go4retro/UltiMEM/media/IMG_0143.jpg

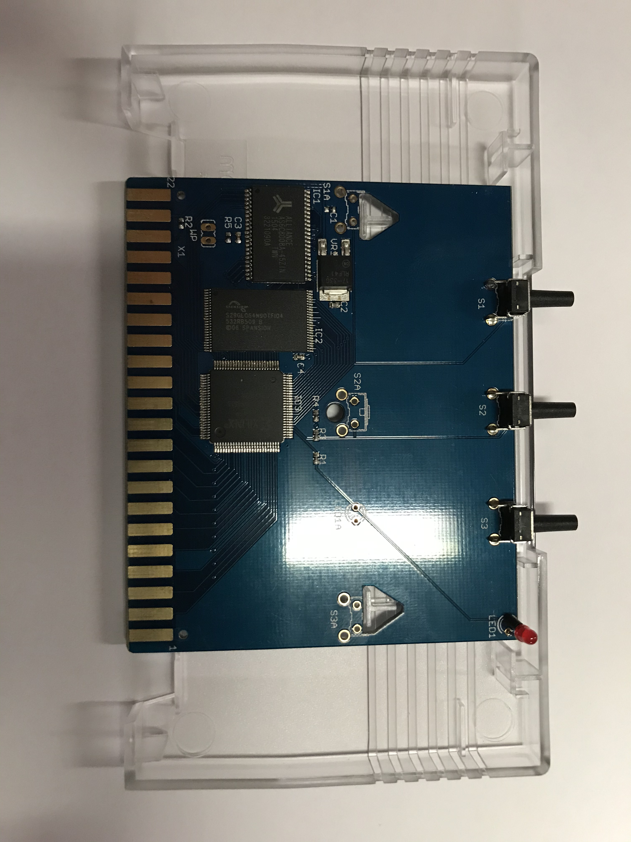
media/IMG_0143.jpg
