go4retro/UltiMEM/media/IMG_0045.JPG

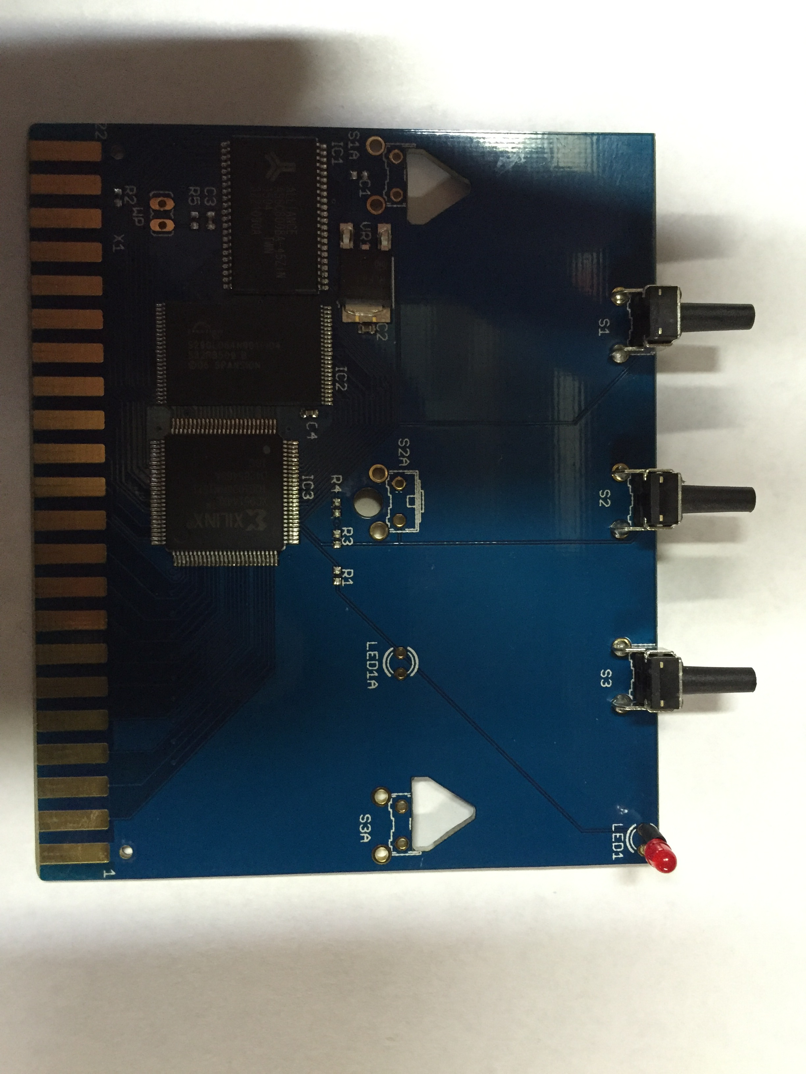
media/IMG_0045.JPG
