go4retro/UltiMEM/media/IMG_0032.JPG

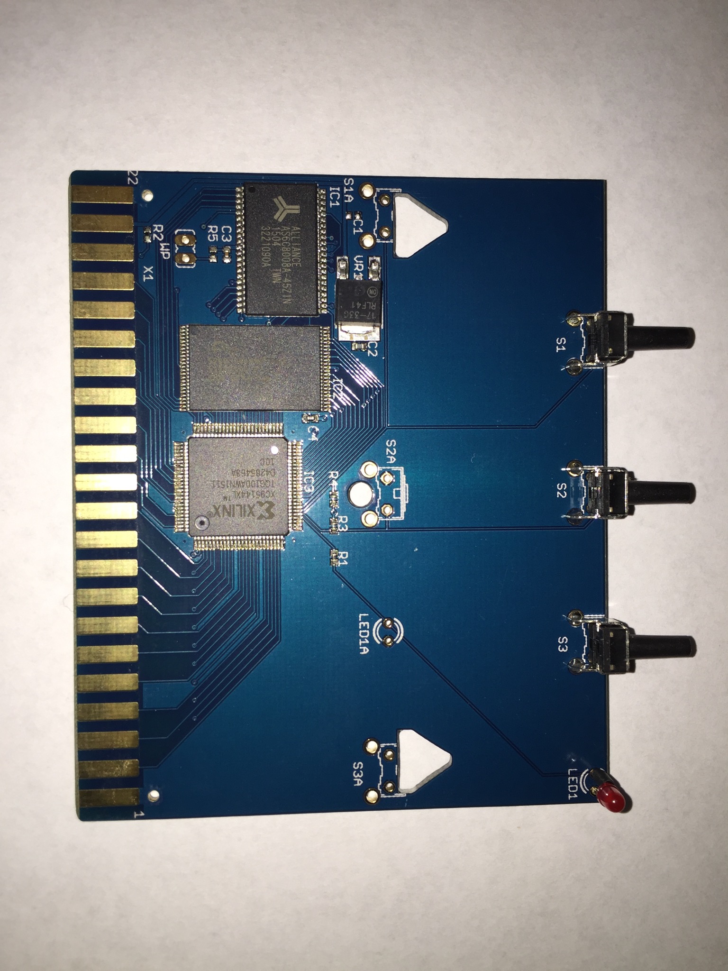
media/IMG_0032.JPG
