go4retro/UltiMEM/media/IMG_0143.JPEG

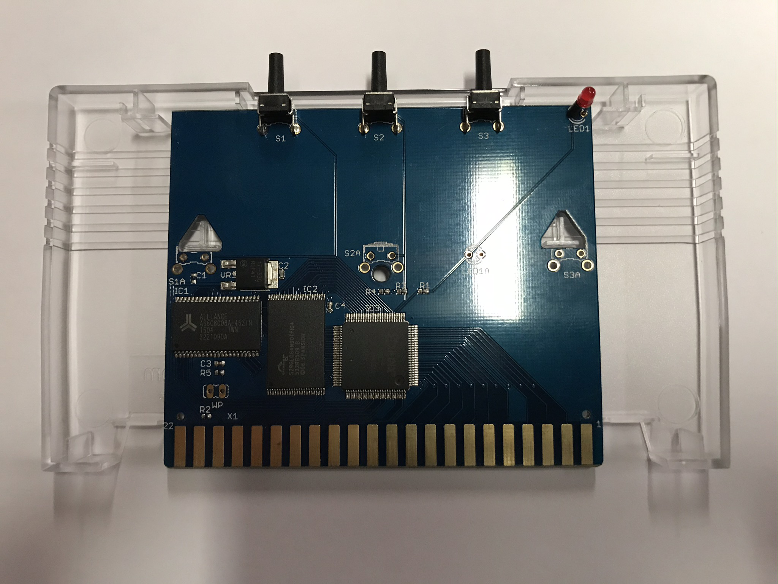
media/IMG_0143.JPEG
