go4retro/UltiMEM/media/IMG_0146.JPEG

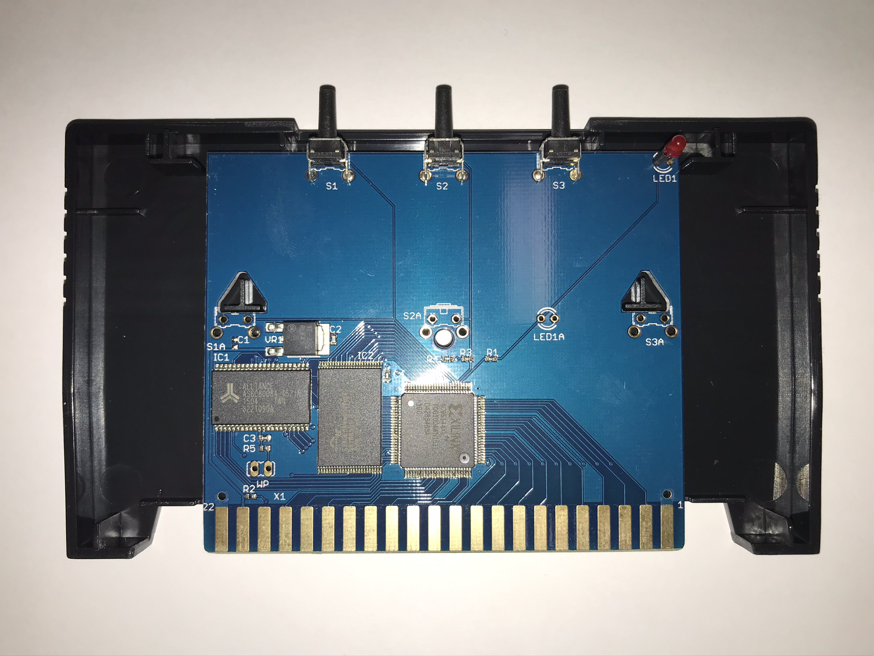
media/IMG_0146.JPEG
