go4retro/UltiMEM/media/IMG_0146.jpg

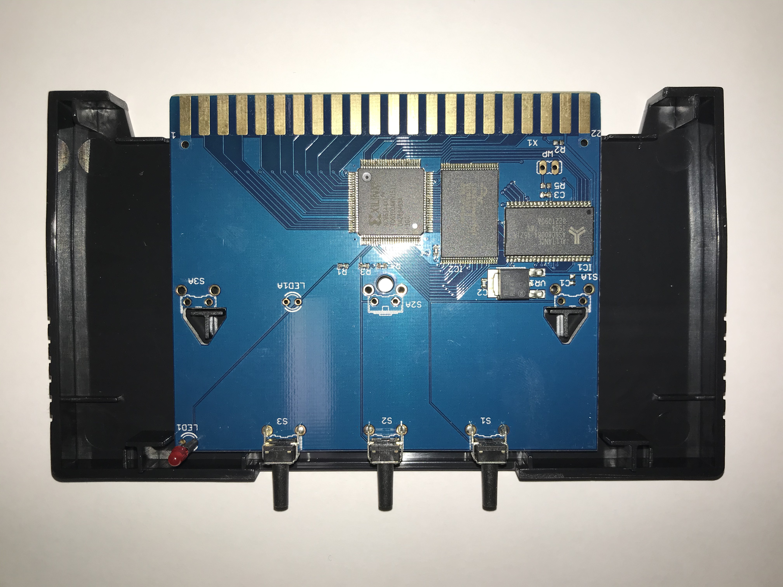
media/IMG_0146.jpg
