go4retro/UltiMEM/media/IMG_1708.JPG

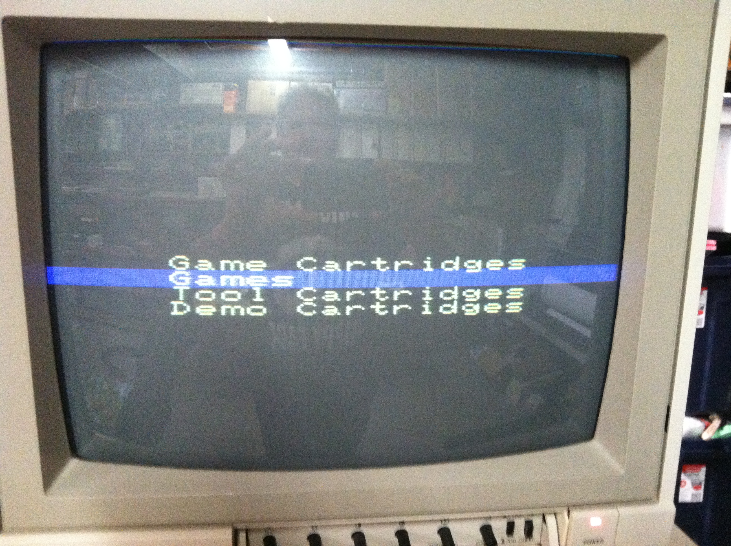
media/IMG_1708.JPG
