go4retro/UltiMEM/media/IMG_1709.JPG

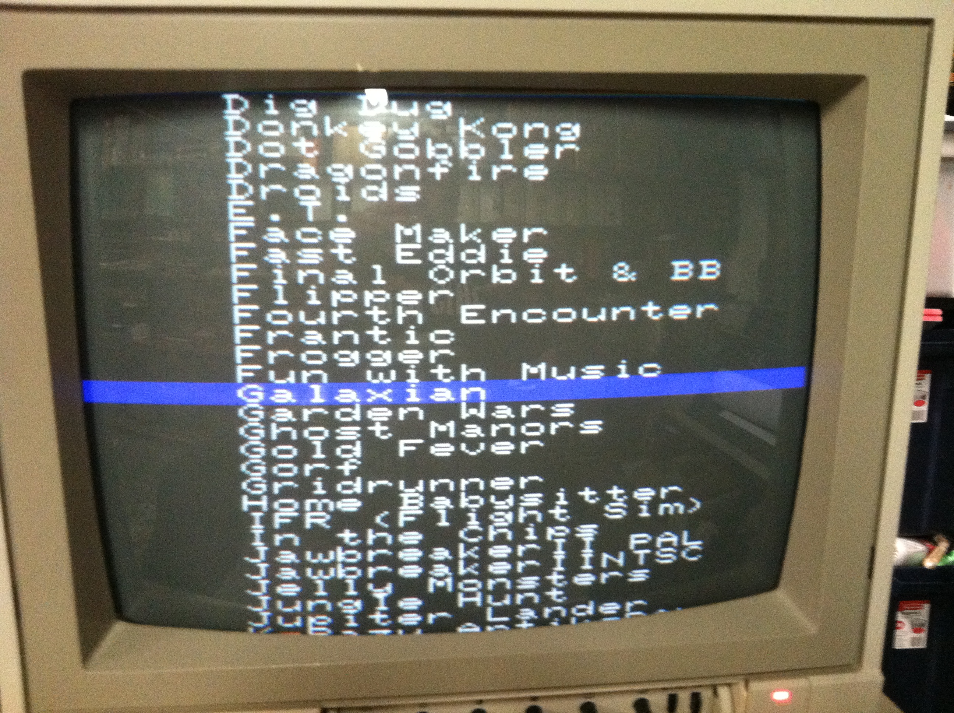
media/IMG_1709.JPG
