go4retro/UltiMEM/media/IMG_1710.JPG

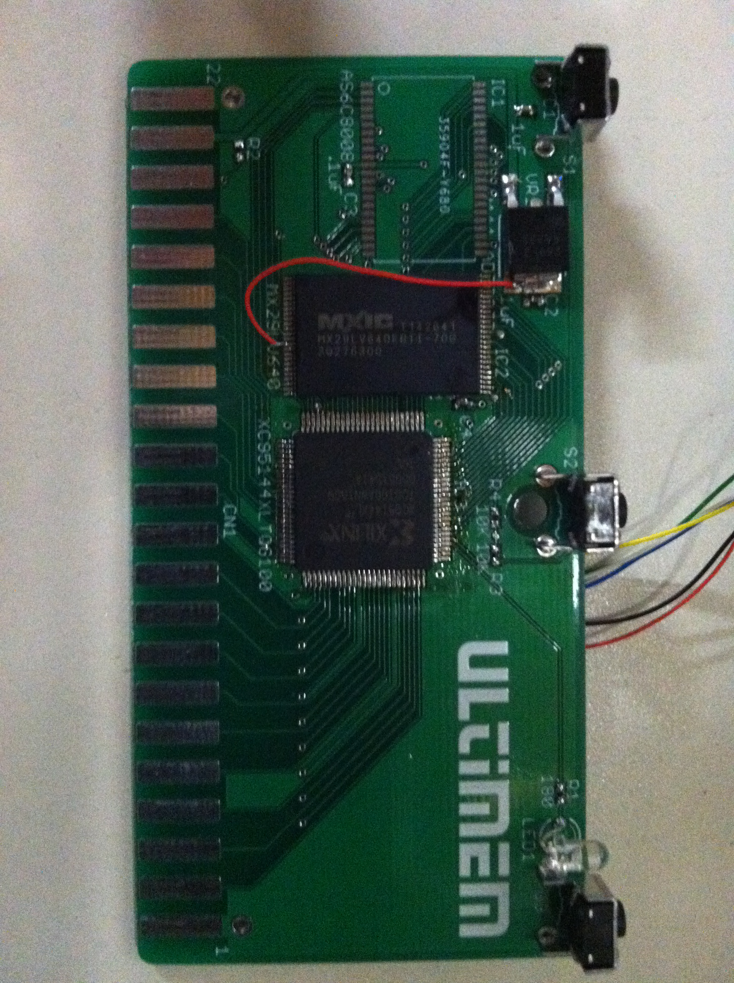
media/IMG_1710.JPG
