go4retro/UltiMEM/media/IMG_1711.JPG

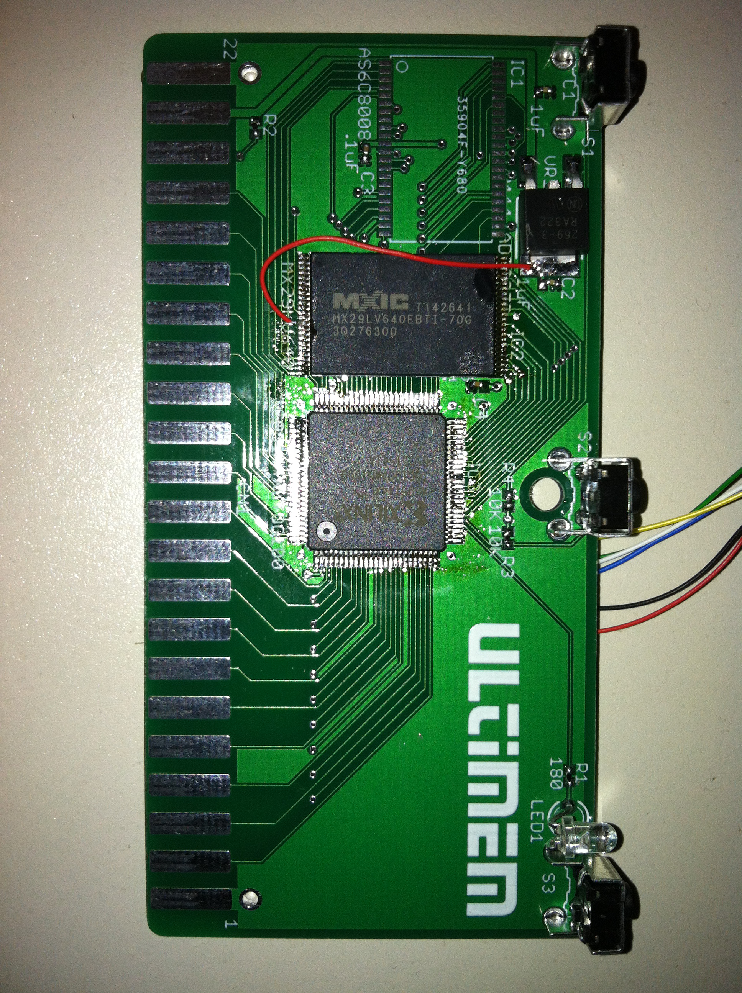
media/IMG_1711.JPG
