go4retro/UltiMEM/media/UltiMem PCB.png

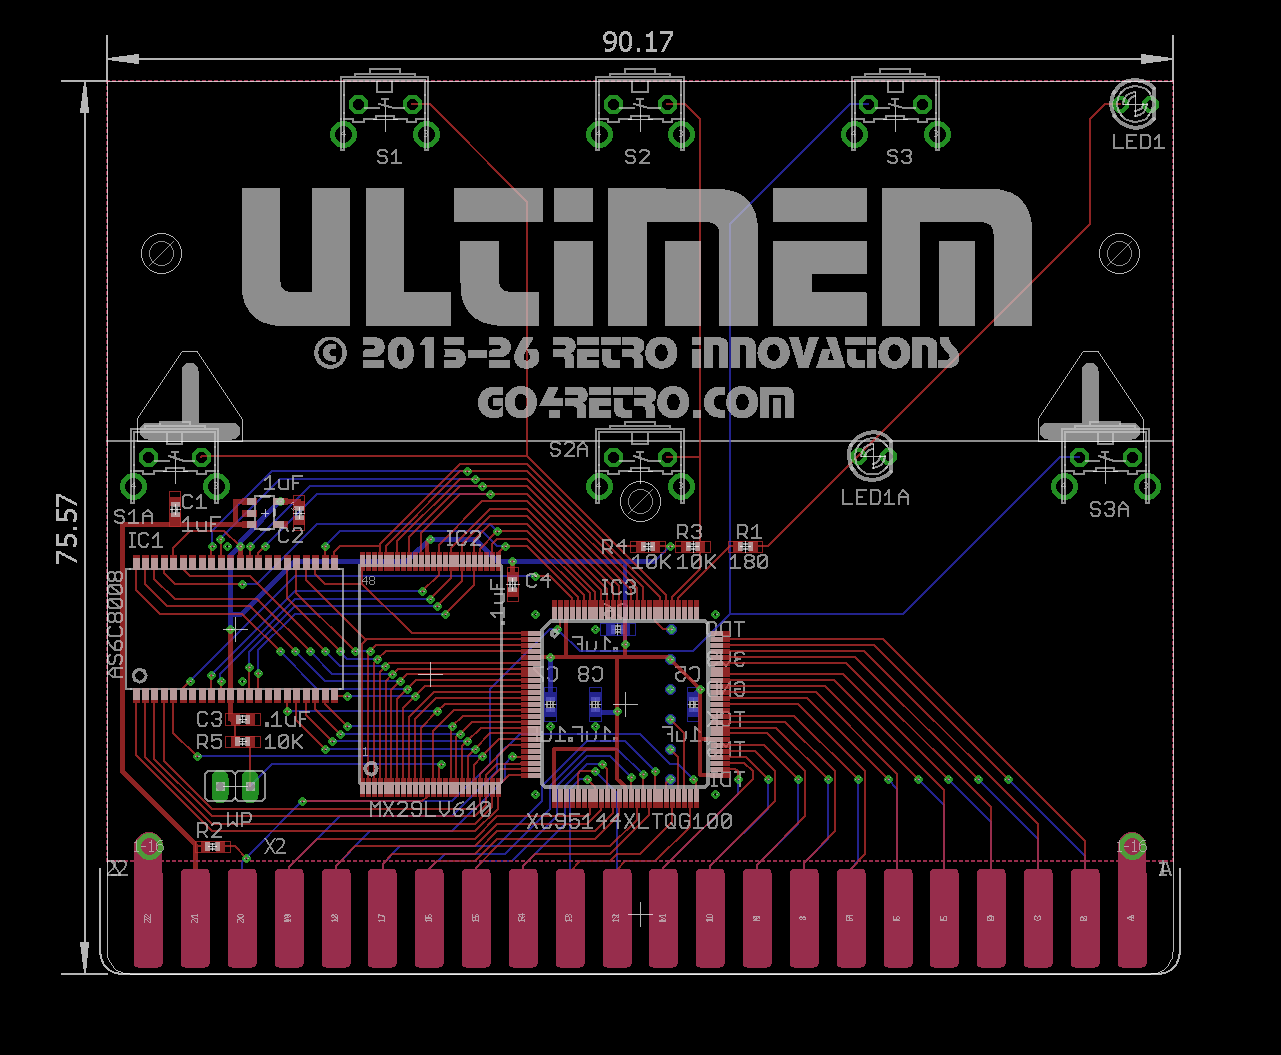
media/UltiMem PCB.png
