go4retro/UltiMEM/media/UltiMem Schematic (1 of 5).png

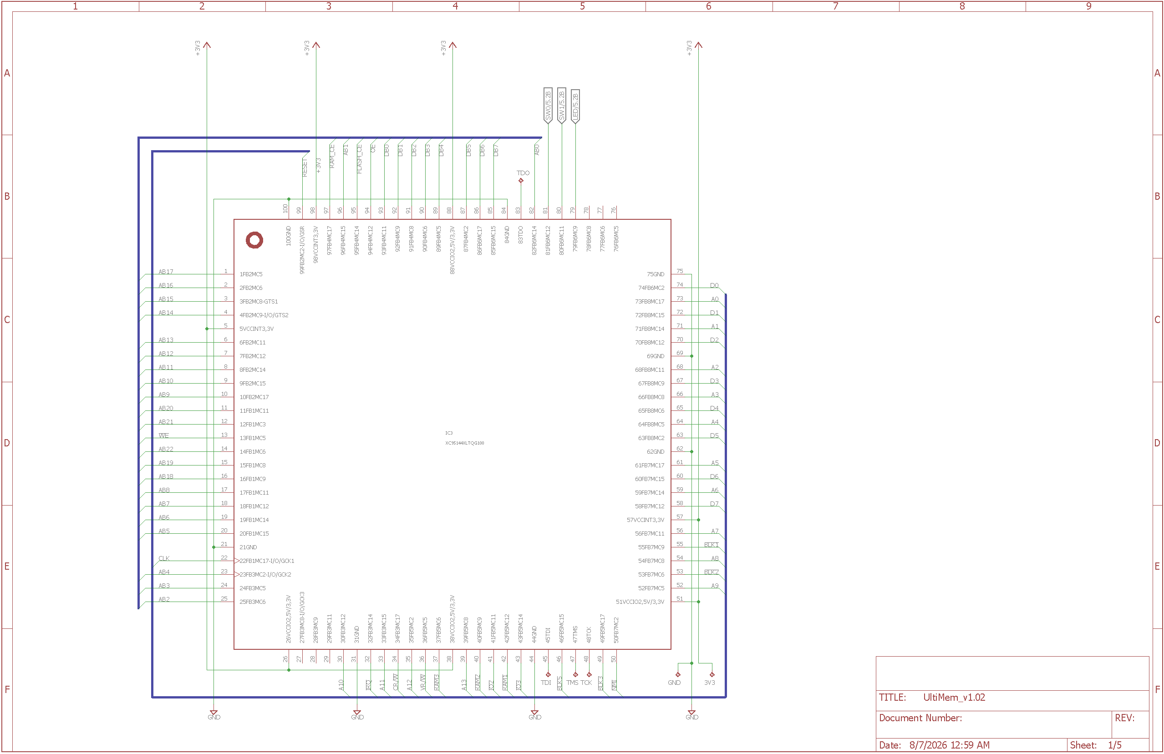
media/UltiMem Schematic (1 of 5).png
