go4retro/UltiMEM/media/UltiMem Schematic (2 of 5).png

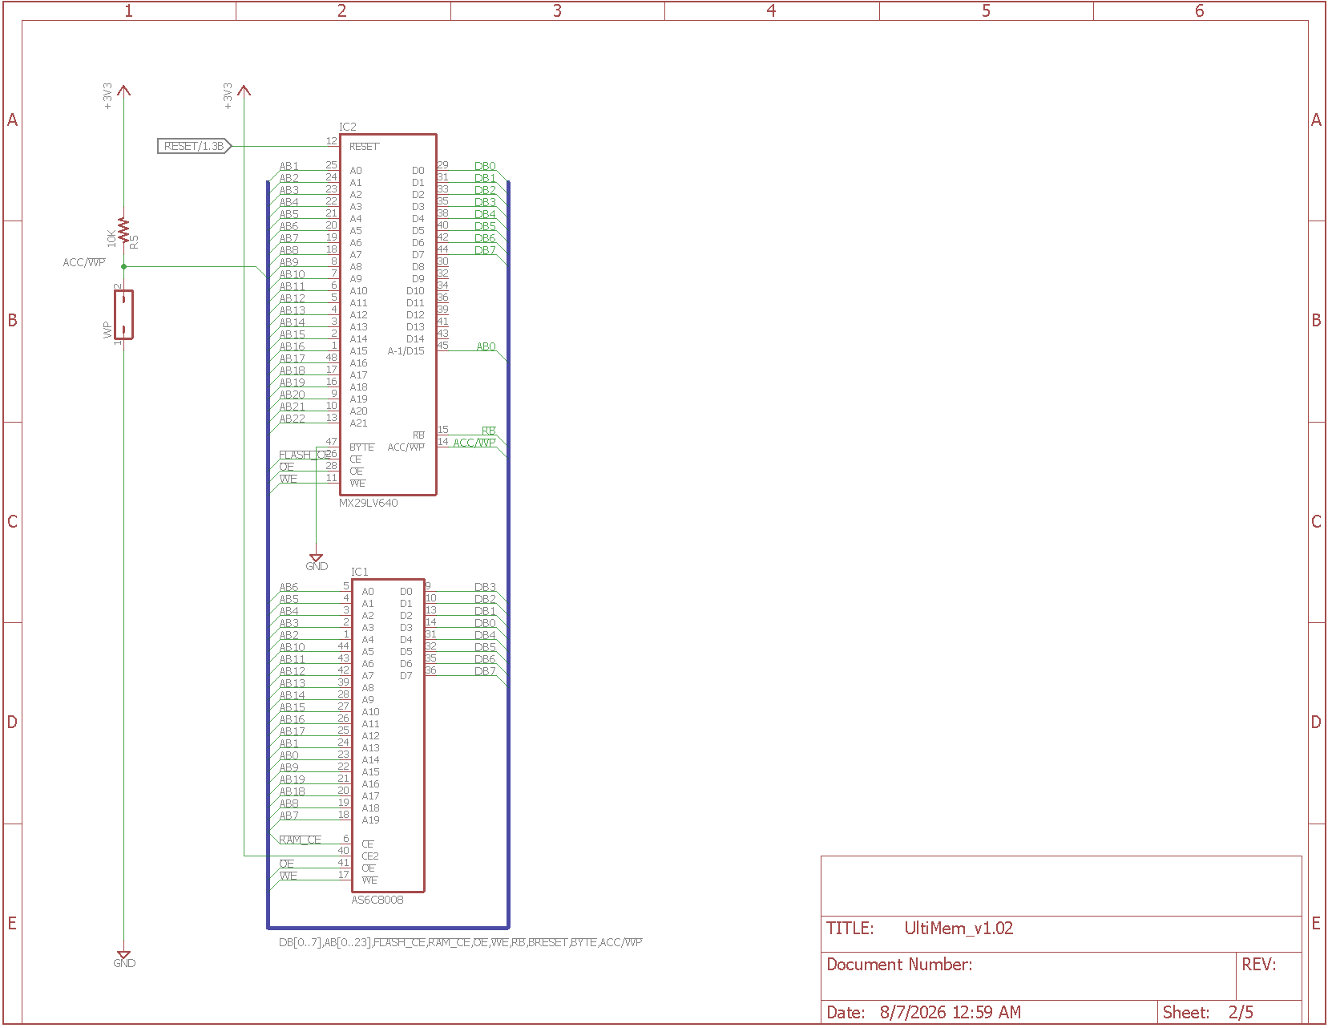
media/UltiMem Schematic (2 of 5).png
