go4retro/UltiMEM/media/UltiMem Schematic (3 of 5).png

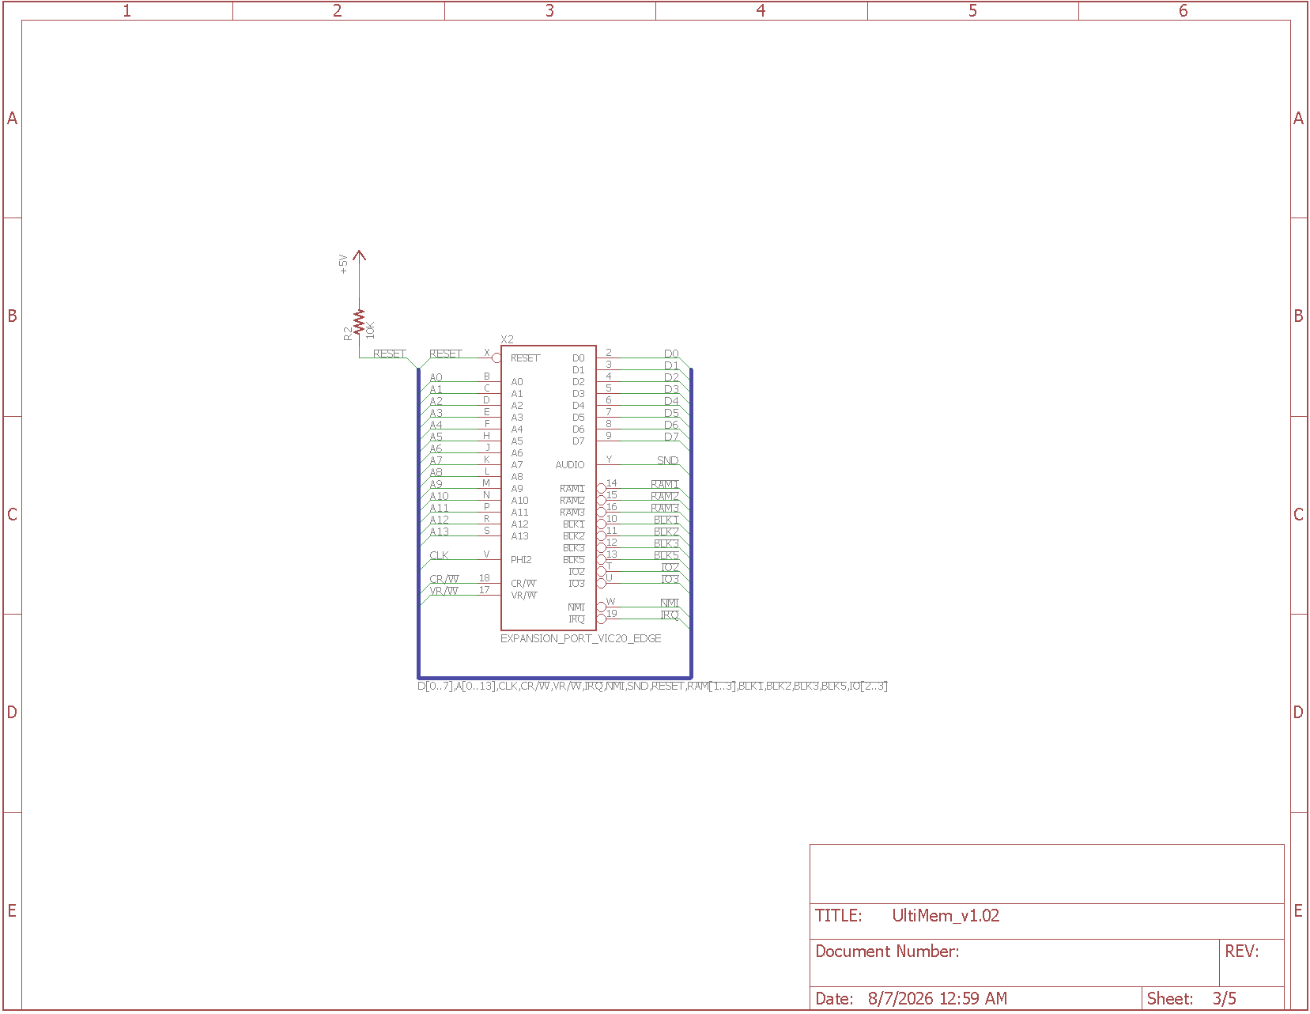
media/UltiMem Schematic (3 of 5).png
