go4retro/UltiMEM/media/UltiMem Schematic (4 of 5).png

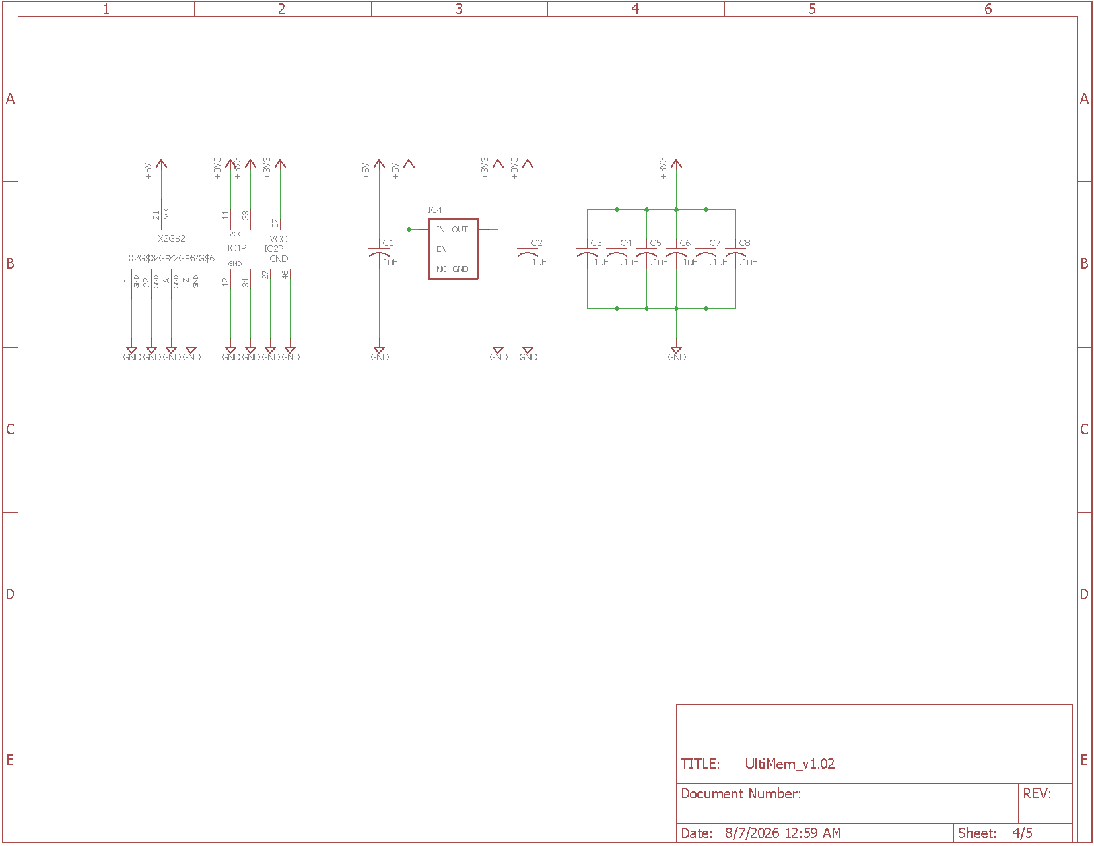
media/UltiMem Schematic (4 of 5).png
