go4retro/UltiMEM/media/UltiMem Schematic (5 of 5).png

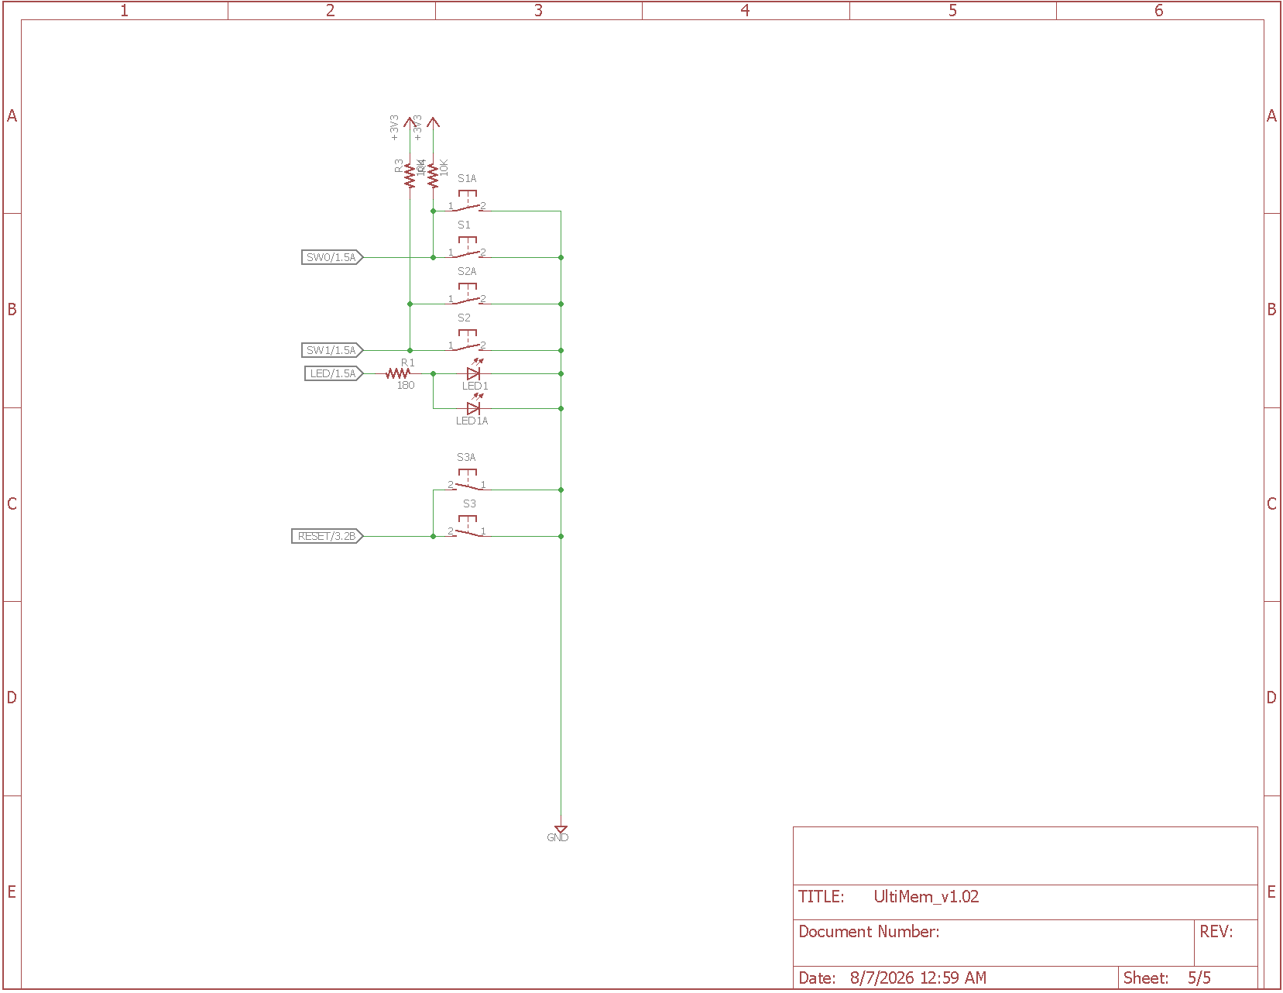
media/UltiMem Schematic (5 of 5).png
