go4retro/UltiMEM/pcb/UltiMem PCB.png

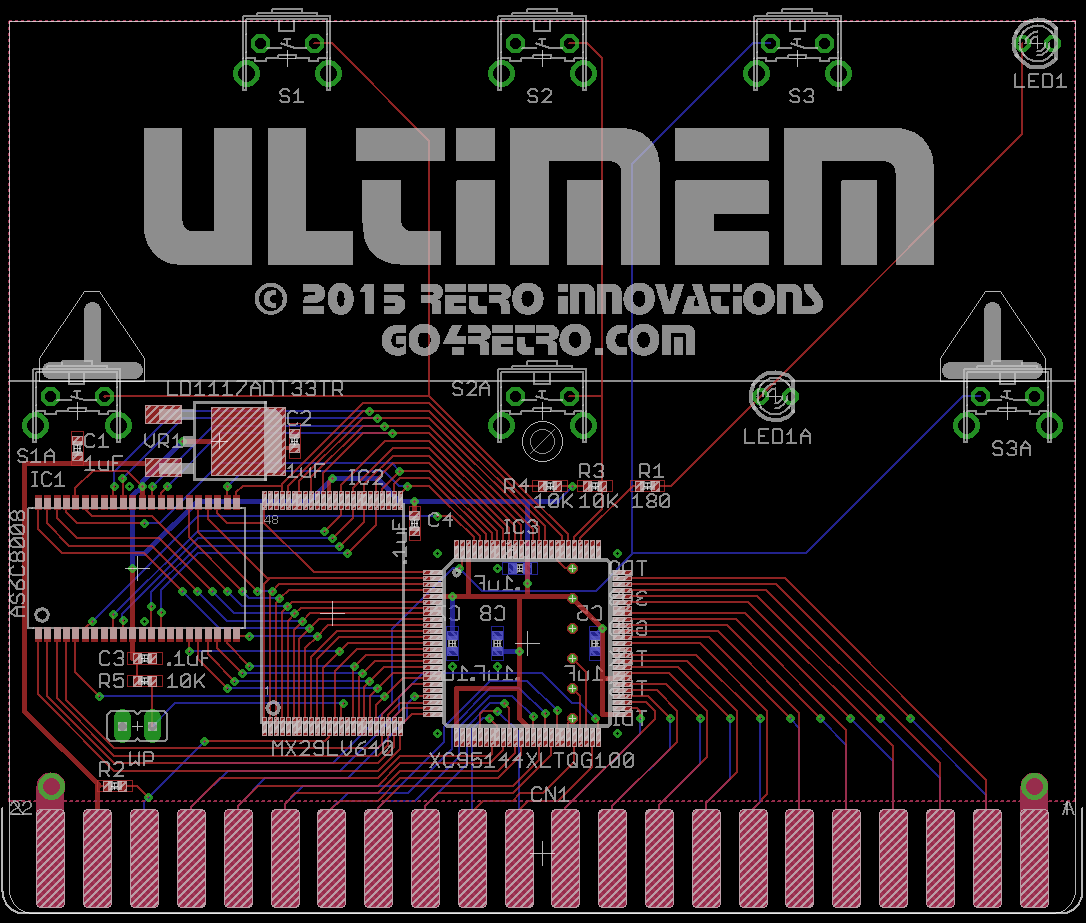
pcb/UltiMem PCB.png
