go4retro/UltiMEM/pcb/UltiMem Schematic (1 of 3).png

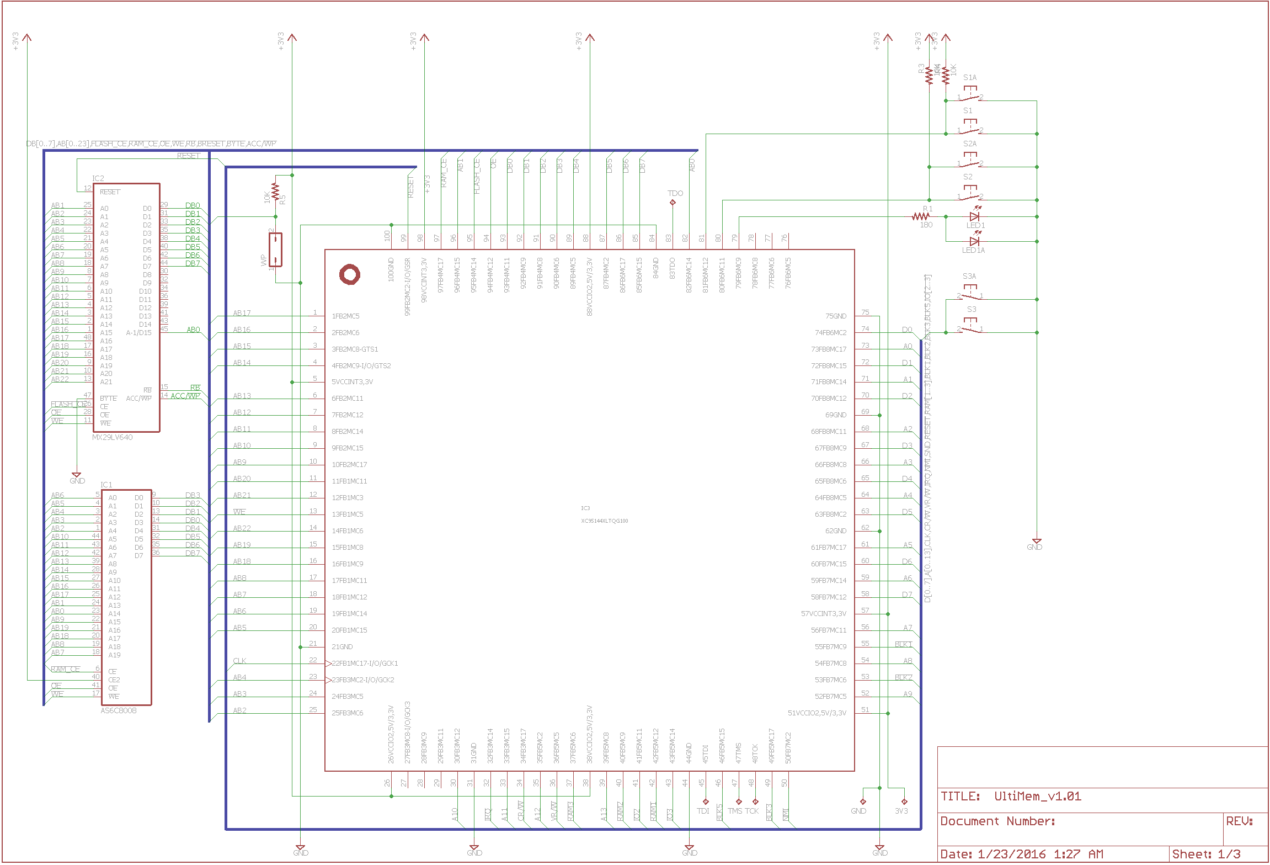
pcb/UltiMem Schematic (1 of 3).png
