go4retro/UltiMEM/pcb/UltiMem Schematic (2 of 3).png

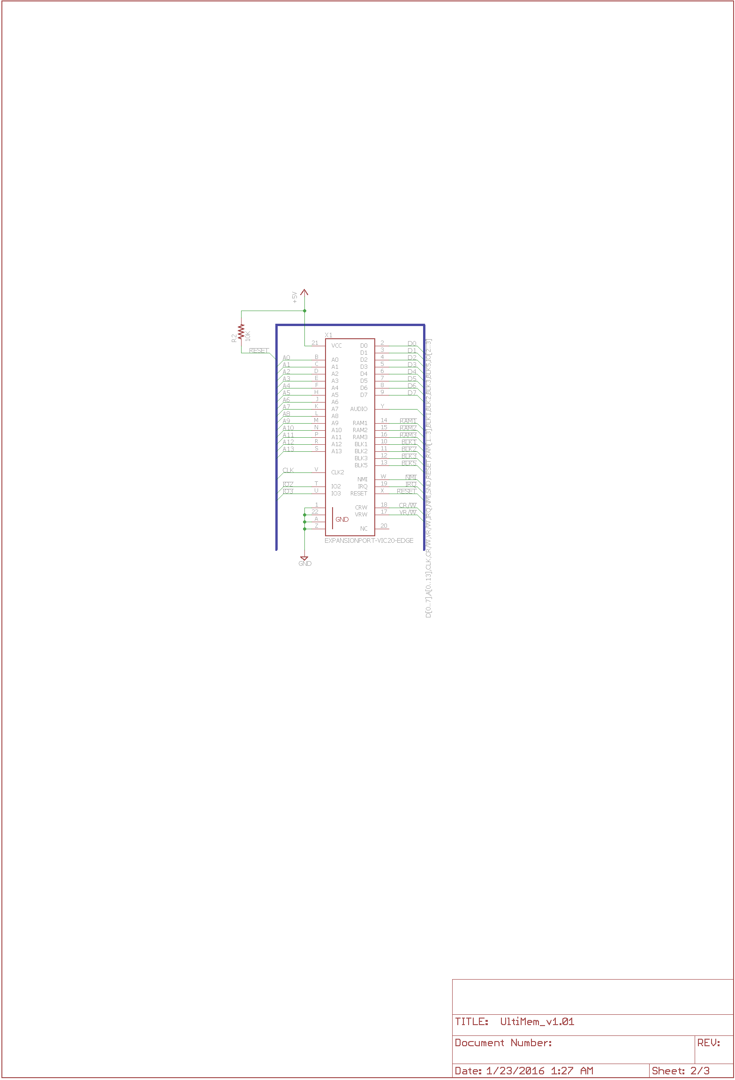
pcb/UltiMem Schematic (2 of 3).png
