go4retro/UltiMEM/pcb/UltiMem Schematic (3 of 3).png

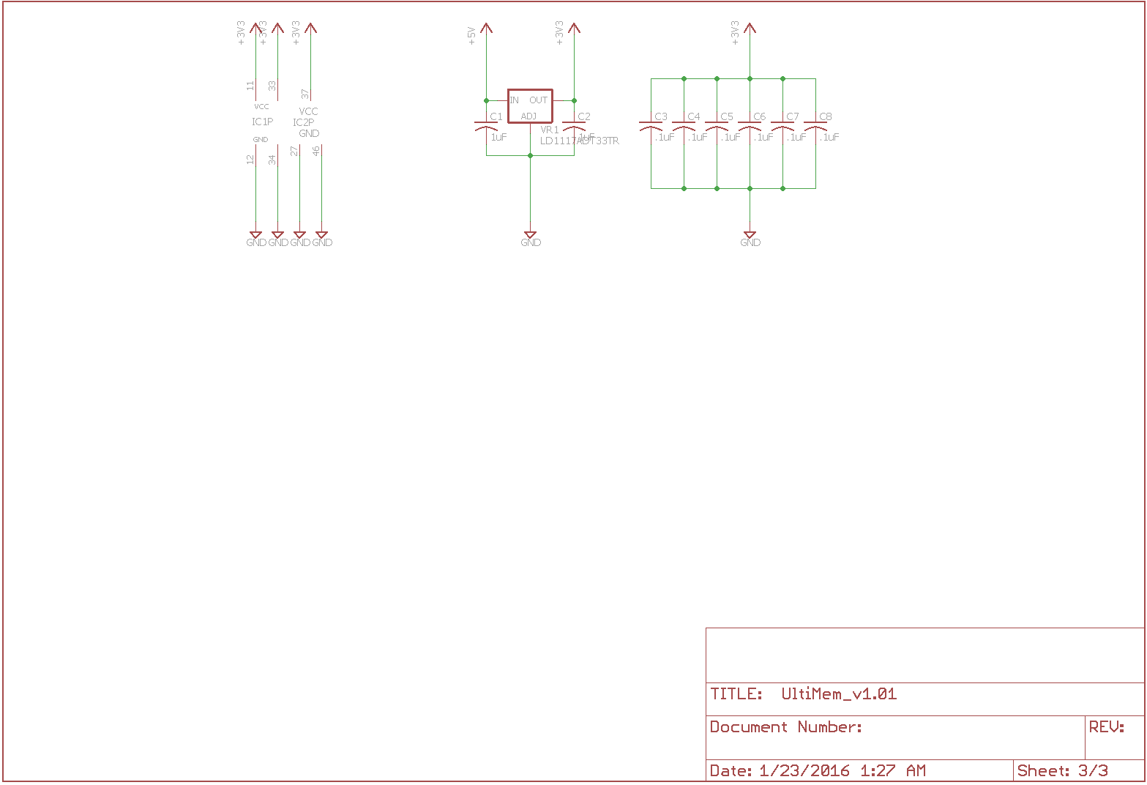
pcb/UltiMem Schematic (3 of 3).png
