go4retro/UltiMEM/pcb/UltiMem_v1.02_BOM.xlsx

Legend | Quantity | Description | Part Number | Unit Cost | Total
IC1 | 1 | 1MB RAM | AS6C8008-55ZIN | $4.60 | $4.60
IC2 | 1 | 8MB FLASH | S29GL064S70TFI040 | $1.12 | $1.12
IC3 | 1 | CPLD | XC95144XL-TQ100 | $2.40 | $2.40
VR1 | 1 | Voltage regulator | TLV77733PDBVR | $0.31 | $0.31
S1,S2,S3 | 3 | RA tactile switch | TS11-674-85-BK-160-RA-D | $0.10 | $0.31
LED1 | 1 | LED | XCMDK11D | $0.14 | $0.14
R1 | 1 | 1K | 0402 package | $0.0047 | $0.0047
R2,R3,R4,R5 | 4 | 10K | 0402 package | $0.01 | $0.03
C1,C2 | 2 | 1uF | 0402 pkg | $0.19 | $0.39
C3-C8 | 6 | .1uF | 0402 pkg | $0.01 | $0.06
