go4retro/UltiMEM/pcb/UltiMem_1.01_BOM.xlsm

Legend | Quantity | Description | Part Number
IC1 | 1 | 1MB RAM | AS6C8008A-45ZIN (http://www.digikey.com/product-detail/en/AS6C8008A-45ZIN/1450-1189-5-ND/4499097)
IC2 | 1 | 8MB FLASH | S29GL064N90TFI040
IC3 | 1 | CPLD | XC95144XL-TQ100
VR1 | 1 | Voltage regulator | LD1117ADT33TR
S1,S2,S3 | 3 | RA tactile switch
LED1 | 1 | LED | WP710A10LSRD
R1 | 1 | 1K | 0402 package
R2,R3,R4,R5 | 4 | 10K | 0402 package
C1,C2 | 2 | 10uF | 0402 pkg
C3-C8 | 6 | .1uF | 0402 pkg
