go4retro/UltiMEM/pcb/UltiMem_v1.02.brd

## EAGLE design pcb/UltiMem_v1.02.brd (2026-08-27)

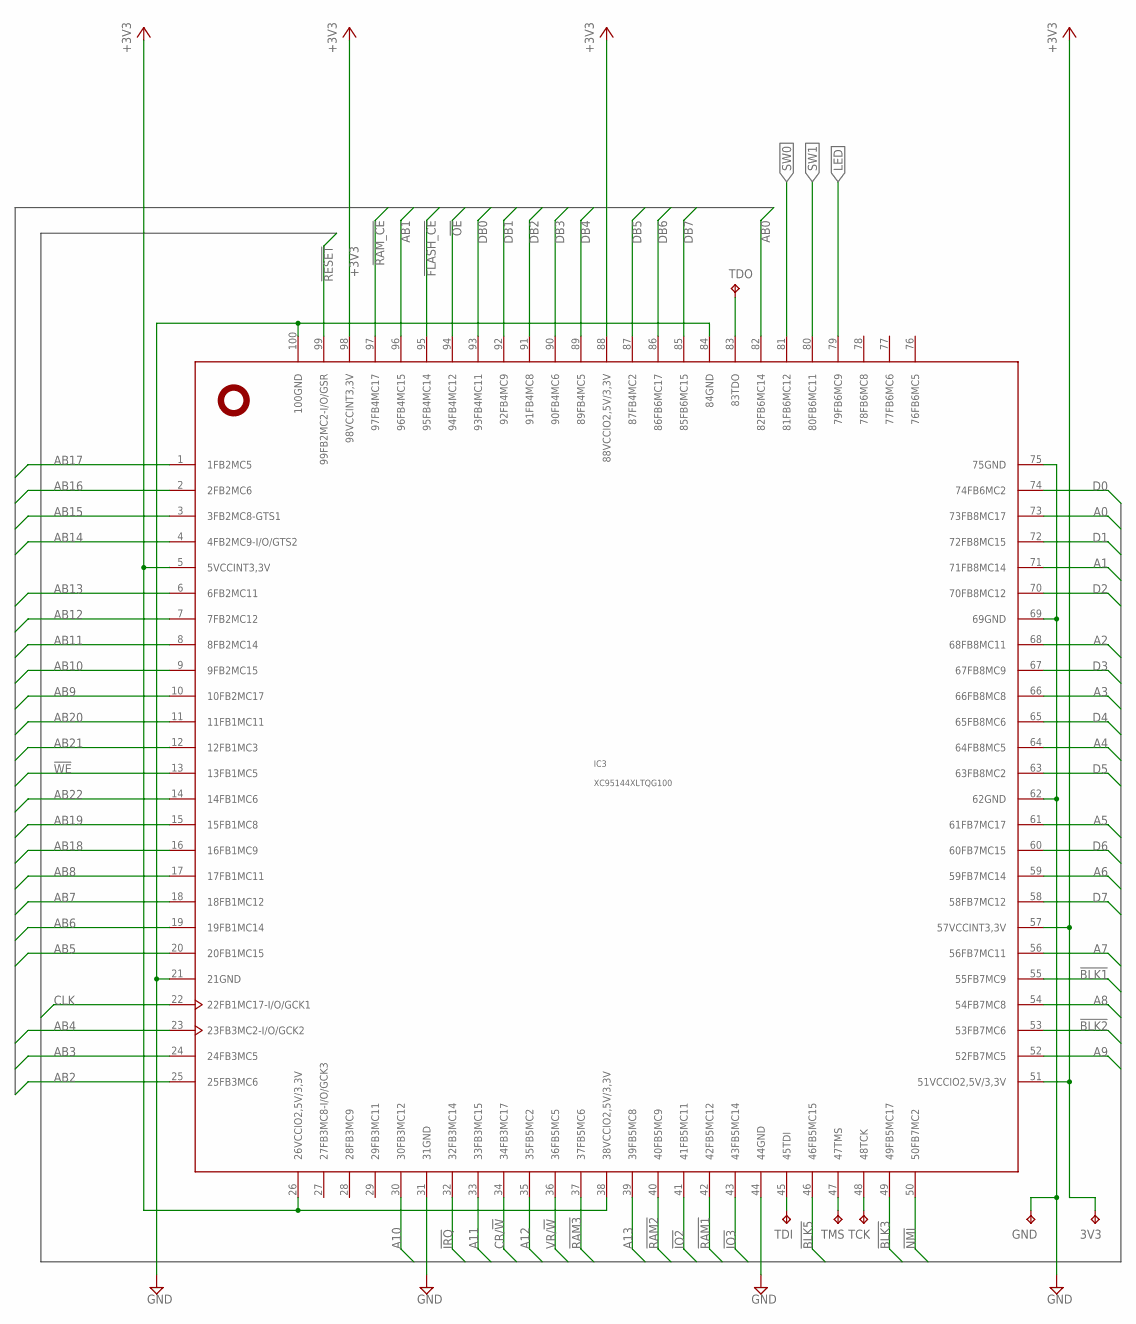
[picture p23: schematic UltiMem_v1.02.sch, sheet 1, LOGIC]

Parts:
3V3: TPTP08R; TP08R
GND: TPTP08R; TP08R
IC3: XC95144XLTQG100; TQFP100
TCK: TPTP08R; TP08R
TDI: TPTP08R; TP08R
TDO: TPTP08R; TP08R
TMS: TPTP08R; TP08R

Connections:
!BLK1: IC3.55 (55FB7MC9); also elsewhere on the board
!BLK2: IC3.53 (53FB7MC6); also elsewhere on the board
!BLK3: IC3.49 (49FB5MC17); also elsewhere on the board
!BLK5: IC3.46 (46FB5MC15); also elsewhere on the board
!FLASH_CE: IC3.95 (95FB4MC14); also elsewhere on the board
!IO2: IC3.41 (41FB5MC11); also elsewhere on the board
!IO3: IC3.43 (43FB5MC14); also elsewhere on the board
!IRQ: IC3.32 (32FB3MC14); also elsewhere on the board
!NMI: IC3.50 (50FB7MC2); also elsewhere on the board
!OE: IC3.94 (94FB4MC12); also elsewhere on the board
!RAM1: IC3.42 (42FB5MC12); also elsewhere on the board
!RAM2: IC3.40 (40FB5MC9); also elsewhere on the board
!RAM3: IC3.37 (37FB5MC6); also elsewhere on the board
!RAM_CE: IC3.97 (97FB4MC17); also elsewhere on the board
!RESET: IC3.99 (99FB2MC2-I/O/GSR); also elsewhere on the board
!WE: IC3.13 (13FB1MC5); also elsewhere on the board
+3V3: 3V3.TP, IC3.5 (5VCCINT3,3V), IC3.26 (26VCCIO2,5V/3,3V), IC3.38 (38VCCIO2,5V/3,3V), IC3.51 (51VCCIO2,5V/3,3V), IC3.57 (57VCCINT3,3V), IC3.88 (88VCCIO2,5V/3,3V), IC3.98 (98VCCINT3,3V); also elsewhere on the board
A0: IC3.73 (73FB8MC17); also elsewhere on the board
A1: IC3.71 (71FB8MC14); also elsewhere on the board
A2: IC3.68 (68FB8MC11); also elsewhere on the board
A3: IC3.66 (66FB8MC8); also elsewhere on the board
A4: IC3.64 (64FB8MC5); also elsewhere on the board
A5: IC3.61 (61FB7MC17); also elsewhere on the board
A6: IC3.59 (59FB7MC14); also elsewhere on the board
A7: IC3.56 (56FB7MC11); also elsewhere on the board
A8: IC3.54 (54FB7MC8); also elsewhere on the board
A9: IC3.52 (52FB7MC5); also elsewhere on the board
A10: IC3.30 (30FB3MC12); also elsewhere on the board
A11: IC3.33 (33FB3MC15); also elsewhere on the board
A12: IC3.35 (35FB5MC2); also elsewhere on the board
A13: IC3.39 (39FB5MC8); also elsewhere on the board
AB0: IC3.82 (82FB6MC14); also elsewhere on the board
AB1: IC3.96 (96FB4MC15); also elsewhere on the board
AB2: IC3.25 (25FB3MC6); also elsewhere on the board
AB3: IC3.24 (24FB3MC5); also elsewhere on the board
AB4: IC3.23 (23FB3MC2-I/O/GCK2); also elsewhere on the board
AB5: IC3.20 (20FB1MC15); also elsewhere on the board
AB6: IC3.19 (19FB1MC14); also elsewhere on the board
AB7: IC3.18 (18FB1MC12); also elsewhere on the board
AB8: IC3.17 (17FB1MC11); also elsewhere on the board
AB9: IC3.10 (10FB2MC17); also elsewhere on the board
AB10: IC3.9 (9FB2MC15); also elsewhere on the board
AB11: IC3.8 (8FB2MC14); also elsewhere on the board
AB12: IC3.7 (7FB2MC12); also elsewhere on the board
AB13: IC3.6 (6FB2MC11); also elsewhere on the board
AB14: IC3.4 (4FB2MC9-I/O/GTS2); also elsewhere on the board
AB15: IC3.3 (3FB2MC8-GTS1); also elsewhere on the board
AB16: IC3.2 (2FB2MC6); also elsewhere on the board
AB17: IC3.1 (1FB2MC5); also elsewhere on the board
AB18: IC3.16 (16FB1MC9); also elsewhere on the board
AB19: IC3.15 (15FB1MC8); also elsewhere on the board
AB20: IC3.11 (11FB1MC11); also elsewhere on the board
AB21: IC3.12 (12FB1MC3); also elsewhere on the board
AB22: IC3.14 (14FB1MC6); also elsewhere on the board
CLK: IC3.22 (22FB1MC17-I/O/GCK1); also elsewhere on the board
CR/!W: IC3.34 (34FB3MC17); also elsewhere on the board
D0: IC3.74 (74FB6MC2); also elsewhere on the board
D1: IC3.72 (72FB8MC15); also elsewhere on the board
D2: IC3.70 (70FB8MC12); also elsewhere on the board
D3: IC3.67 (67FB8MC9); also elsewhere on the board
D4: IC3.65 (65FB8MC6); also elsewhere on the board
D5: IC3.63 (63FB8MC2); also elsewhere on the board
D6: IC3.60 (60FB7MC15); also elsewhere on the board
D7: IC3.58 (58FB7MC12); also elsewhere on the board
DB0: IC3.93 (93FB4MC11); also elsewhere on the board
DB1: IC3.92 (92FB4MC9); also elsewhere on the board
DB2: IC3.91 (91FB4MC8); also elsewhere on the board
DB3: IC3.90 (90FB4MC6); also elsewhere on the board
DB4: IC3.89 (89FB4MC5); also elsewhere on the board
DB5: IC3.87 (87FB4MC2); also elsewhere on the board
DB6: IC3.86 (86FB6MC17); also elsewhere on the board
DB7: IC3.85 (85FB6MC15); also elsewhere on the board
GND: GND.TP, IC3.21 (21GND), IC3.31 (31GND), IC3.44 (44GND), IC3.62 (62GND), IC3.69 (69GND), IC3.75 (75GND), IC3.84 (84GND), IC3.100 (100GND); also elsewhere on the board
LED: IC3.79 (79FB6MC9); also elsewhere on the board
unnamed: IC3.45 (45TDI), TDI.TP
unnamed: IC3.47 (47TMS), TMS.TP
unnamed: IC3.48 (48TCK), TCK.TP
unnamed: IC3.83 (83TDO), TDO.TP
SW0: IC3.81 (81FB6MC12); also elsewhere on the board
SW1: IC3.80 (80FB6MC11); also elsewhere on the board
VR/!W: IC3.36 (36FB5MC5); also elsewhere on the board

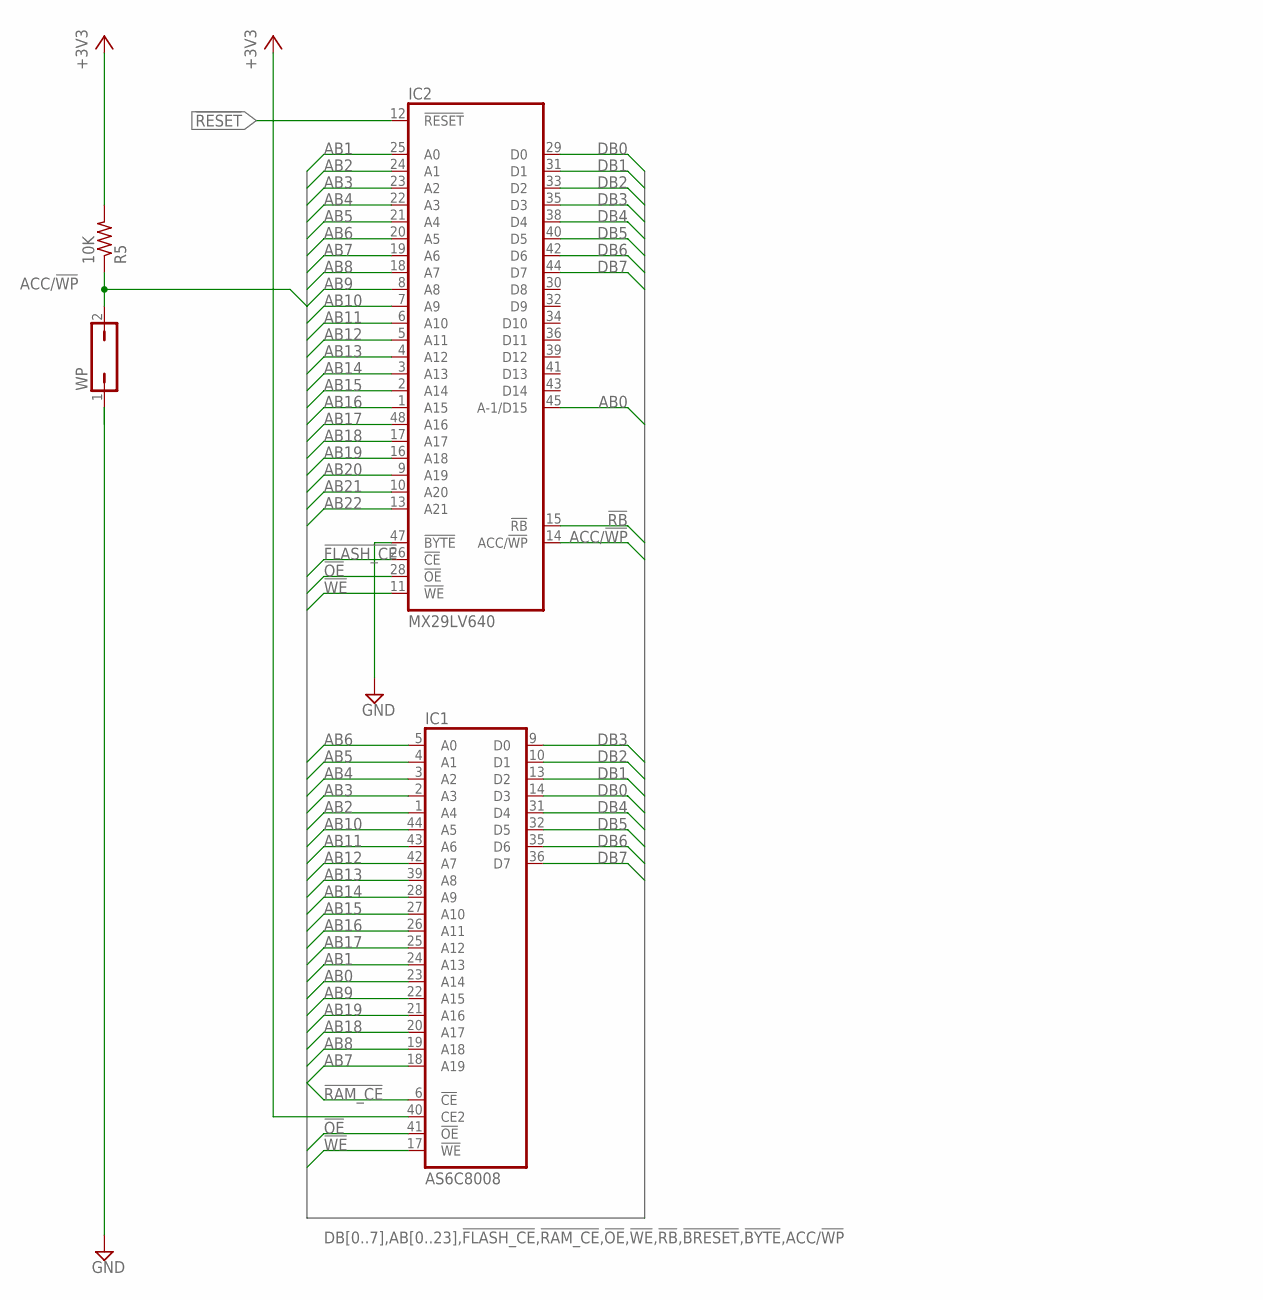
[picture p24: schematic UltiMem_v1.02.sch, sheet 2, MEMORY]

Parts:
IC1: AS6C8008; TSOP44
IC2: MX29LV640; TSOP48
R5: 10K; R0402
WP: JP1Q; JP1

Connections:
!FLASH_CE: IC2.26 (!CE); also elsewhere on the board
!OE: IC1.41 (!OE), IC2.28 (!OE); also elsewhere on the board
!RAM_CE: IC1.6 (!CE); also elsewhere on the board
!RB: IC2.15 (!RB)
!RESET: IC2.12 (!RESET); also elsewhere on the board
!WE: IC1.17 (!WE), IC2.11 (!WE); also elsewhere on the board
+3V3: IC1.40 (CE2), R5.2; also elsewhere on the board
AB0: IC1.23 (A14), IC2.45 (A-1/D15); also elsewhere on the board
AB1: IC1.24 (A13), IC2.25 (A0); also elsewhere on the board
AB2: IC1.1 (A4), IC2.24 (A1); also elsewhere on the board
AB3: IC1.2 (A3), IC2.23 (A2); also elsewhere on the board
AB4: IC1.3 (A2), IC2.22 (A3); also elsewhere on the board
AB5: IC1.4 (A1), IC2.21 (A4); also elsewhere on the board
AB6: IC1.5 (A0), IC2.20 (A5); also elsewhere on the board
AB7: IC1.18 (A19), IC2.19 (A6); also elsewhere on the board
AB8: IC1.19 (A18), IC2.18 (A7); also elsewhere on the board
AB9: IC1.22 (A15), IC2.8 (A8); also elsewhere on the board
AB10: IC1.44 (A5), IC2.7 (A9); also elsewhere on the board
AB11: IC1.43 (A6), IC2.6 (A10); also elsewhere on the board
AB12: IC1.42 (A7), IC2.5 (A11); also elsewhere on the board
AB13: IC1.39 (A8), IC2.4 (A12); also elsewhere on the board
AB14: IC1.28 (A9), IC2.3 (A13); also elsewhere on the board
AB15: IC1.27 (A10), IC2.2 (A14); also elsewhere on the board
AB16: IC1.26 (A11), IC2.1 (A15); also elsewhere on the board
AB17: IC1.25 (A12), IC2.48 (A16); also elsewhere on the board
AB18: IC1.20 (A17), IC2.17 (A17); also elsewhere on the board
AB19: IC1.21 (A16), IC2.16 (A18); also elsewhere on the board
AB20: IC2.9 (A19); also elsewhere on the board
AB21: IC2.10 (A20); also elsewhere on the board
AB22: IC2.13 (A21); also elsewhere on the board
ACC/!WP: IC2.14 (ACC/!WP), R5.1, WP.2
DB0: IC1.14 (D3), IC2.29 (D0); also elsewhere on the board
DB1: IC1.13 (D2), IC2.31 (D1); also elsewhere on the board
DB2: IC1.10 (D1), IC2.33 (D2); also elsewhere on the board
DB3: IC1.9 (D0), IC2.35 (D3); also elsewhere on the board
DB4: IC1.31 (D4), IC2.38 (D4); also elsewhere on the board
DB5: IC1.32 (D5), IC2.40 (D5); also elsewhere on the board
DB6: IC1.35 (D6), IC2.42 (D6); also elsewhere on the board
DB7: IC1.36 (D7), IC2.44 (D7); also elsewhere on the board
GND: IC2.47 (!BYTE), WP.1; also elsewhere on the board

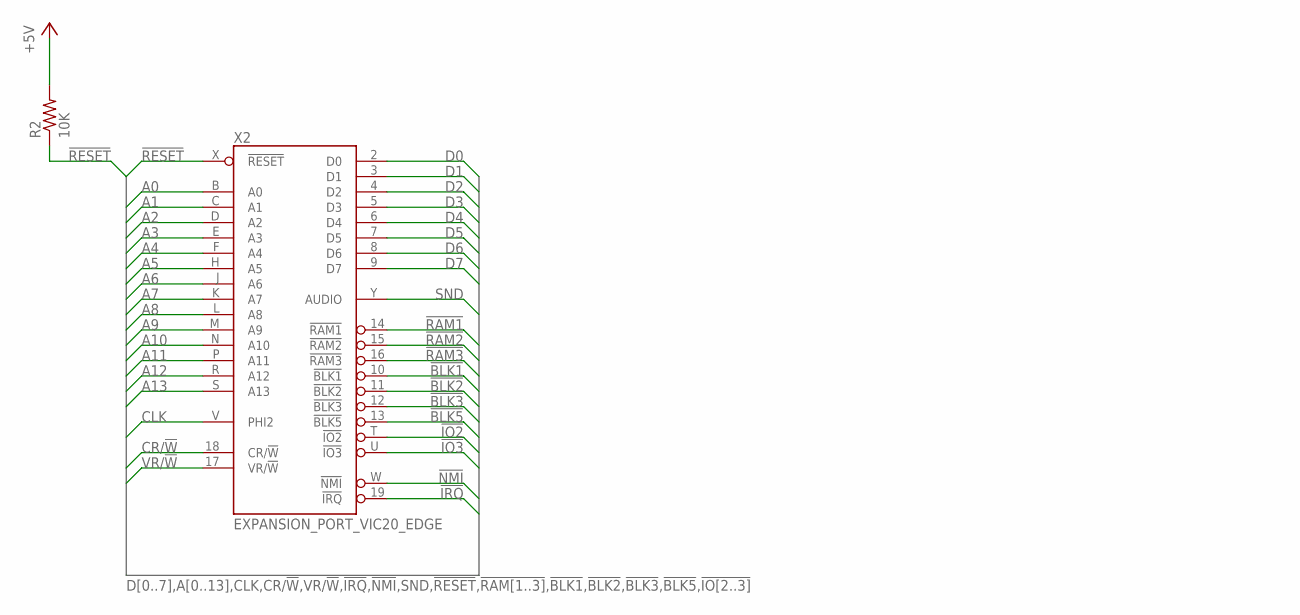
[picture p25: schematic UltiMem_v1.02.sch, sheet 3, INTERFACE]

Parts:
R2: 10K; R0402
X2: EXPANSION_PORT_VIC20_EDGE; MA156-22-2

Connections:
!BLK1: X2.10 (!BLK1); also elsewhere on the board
!BLK2: X2.11 (!BLK2); also elsewhere on the board
!BLK3: X2.12 (!BLK3); also elsewhere on the board
!BLK5: X2.13 (!BLK5); also elsewhere on the board
!IO2: X2.T (!IO2); also elsewhere on the board
!IO3: X2.U (!IO3); also elsewhere on the board
!IRQ: X2.19 (!IRQ); also elsewhere on the board
!NMI: X2.W (!NMI); also elsewhere on the board
!RAM1: X2.14 (!RAM1); also elsewhere on the board
!RAM2: X2.15 (!RAM2); also elsewhere on the board
!RAM3: X2.16 (!RAM3); also elsewhere on the board
!RESET: R2.1, X2.X (!RESET); also elsewhere on the board
+5V: R2.2; also elsewhere on the board
A0: X2.B (A0); also elsewhere on the board
A1: X2.C (A1); also elsewhere on the board
A2: X2.D (A2); also elsewhere on the board
A3: X2.E (A3); also elsewhere on the board
A4: X2.F (A4); also elsewhere on the board
A5: X2.H (A5); also elsewhere on the board
A6: X2.J (A6); also elsewhere on the board
A7: X2.K (A7); also elsewhere on the board
A8: X2.L (A8); also elsewhere on the board
A9: X2.M (A9); also elsewhere on the board
A10: X2.N (A10); also elsewhere on the board
A11: X2.P (A11); also elsewhere on the board
A12: X2.R (A12); also elsewhere on the board
A13: X2.S (A13); also elsewhere on the board
CLK: X2.V (PHI2); also elsewhere on the board
CR/!W: X2.18 (CR/!W); also elsewhere on the board
D0: X2.2 (D0); also elsewhere on the board
D1: X2.3 (D1); also elsewhere on the board
D2: X2.4 (D2); also elsewhere on the board
D3: X2.5 (D3); also elsewhere on the board
D4: X2.6 (D4); also elsewhere on the board
D5: X2.7 (D5); also elsewhere on the board
D6: X2.8 (D6); also elsewhere on the board
D7: X2.9 (D7); also elsewhere on the board
SND: X2.Y (AUDIO)
VR/!W: X2.17 (VR/!W); also elsewhere on the board

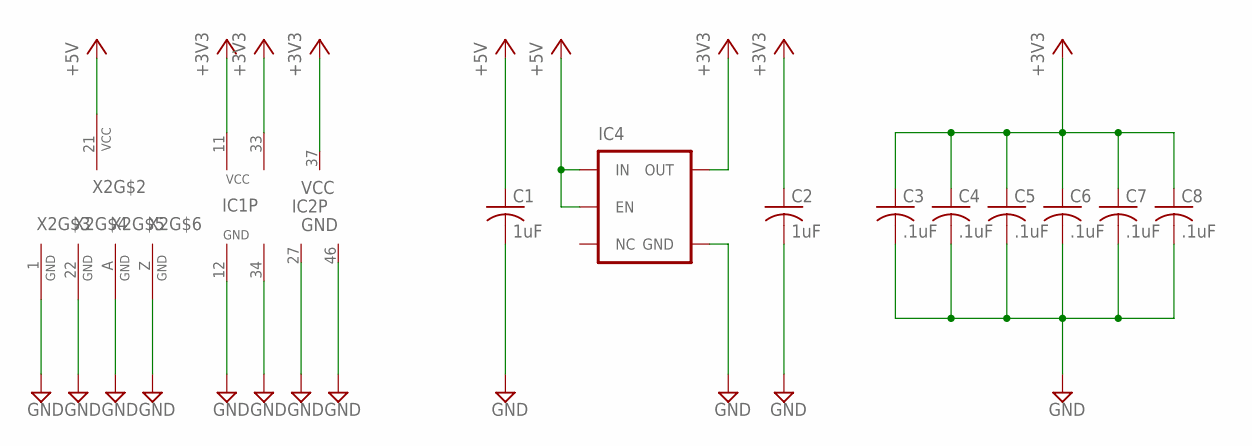
[picture p26: schematic UltiMem_v1.02.sch, sheet 4, POWER]

Parts:
C1, C2: 1uF; C0402
C3, C4, C5, C6, C7, C8: .1uF; C0402
IC1: AS6C8008; TSOP44
IC2: MX29LV640; TSOP48
IC4: V_REG_TPS76433SOT23-5; SOT23-5
X2: EXPANSION_PORT_VIC20_EDGE; MA156-22-2

Connections:
+3V3: C2.1, C3.1, C4.1, C5.1, C6.1, C7.1, C8.1, IC1.11 (VCC), IC1.33 (VCC), IC2.37 (VCC), IC4.5 (OUT); also elsewhere on the board
+5V: C1.1, IC4.1 (IN), IC4.3 (EN), X2.21 (VCC); also elsewhere on the board
GND: C1.2, C2.2, C3.2, C4.2, C5.2, C6.2, C7.2, C8.2, IC1.12 (GND), IC1.34 (GND), IC2.27 (GND), IC2.46 (GND), IC4.2 (GND), X2.1 (GND), X2.22 (GND), X2.A (GND), X2.Z (GND); also elsewhere on the board

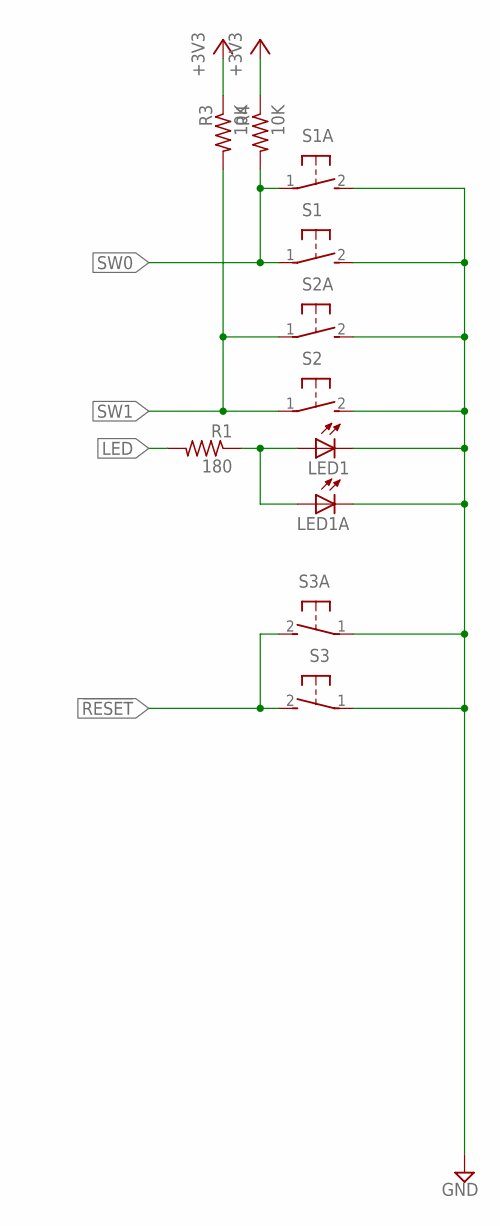
[picture p27: schematic UltiMem_v1.02.sch, sheet 5, IO]

Parts:
LED1, LED1A: LED3MM
R1: 180; R0402
R3, R4: 10K; R0402
S1, S1A, S2, S2A, S3, S3A: 31-XX; B3F-31XX

Connections:
!RESET: S3.2 (S), S3A.2 (S); also elsewhere on the board
+3V3: R3.1, R4.1; also elsewhere on the board
GND: LED1.K (C), LED1A.K (C), S1.2 (S), S1A.2 (S), S2.2 (S), S2A.2 (S), S3.1, S3A.1; also elsewhere on the board
LED: R1.2; also elsewhere on the board
unnamed: LED1.A, LED1A.A, R1.1
SW0: R4.2, S1.1, S1A.1; also elsewhere on the board
SW1: R3.2, S2.1, S2A.1; also elsewhere on the board

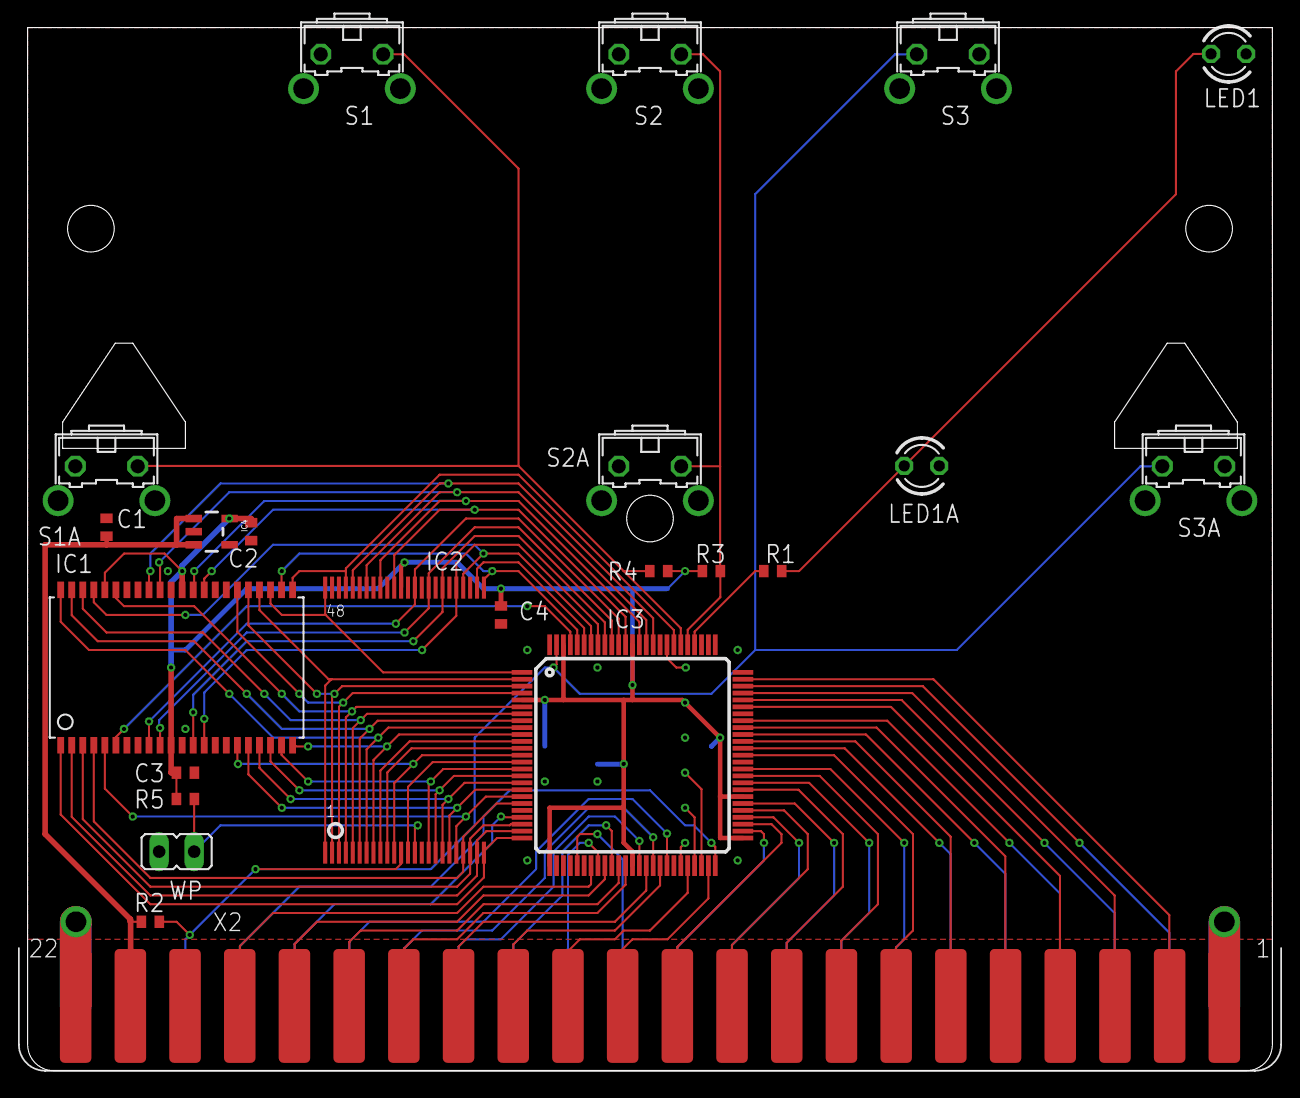
[picture p28: board UltiMem_v1.02.brd from above]

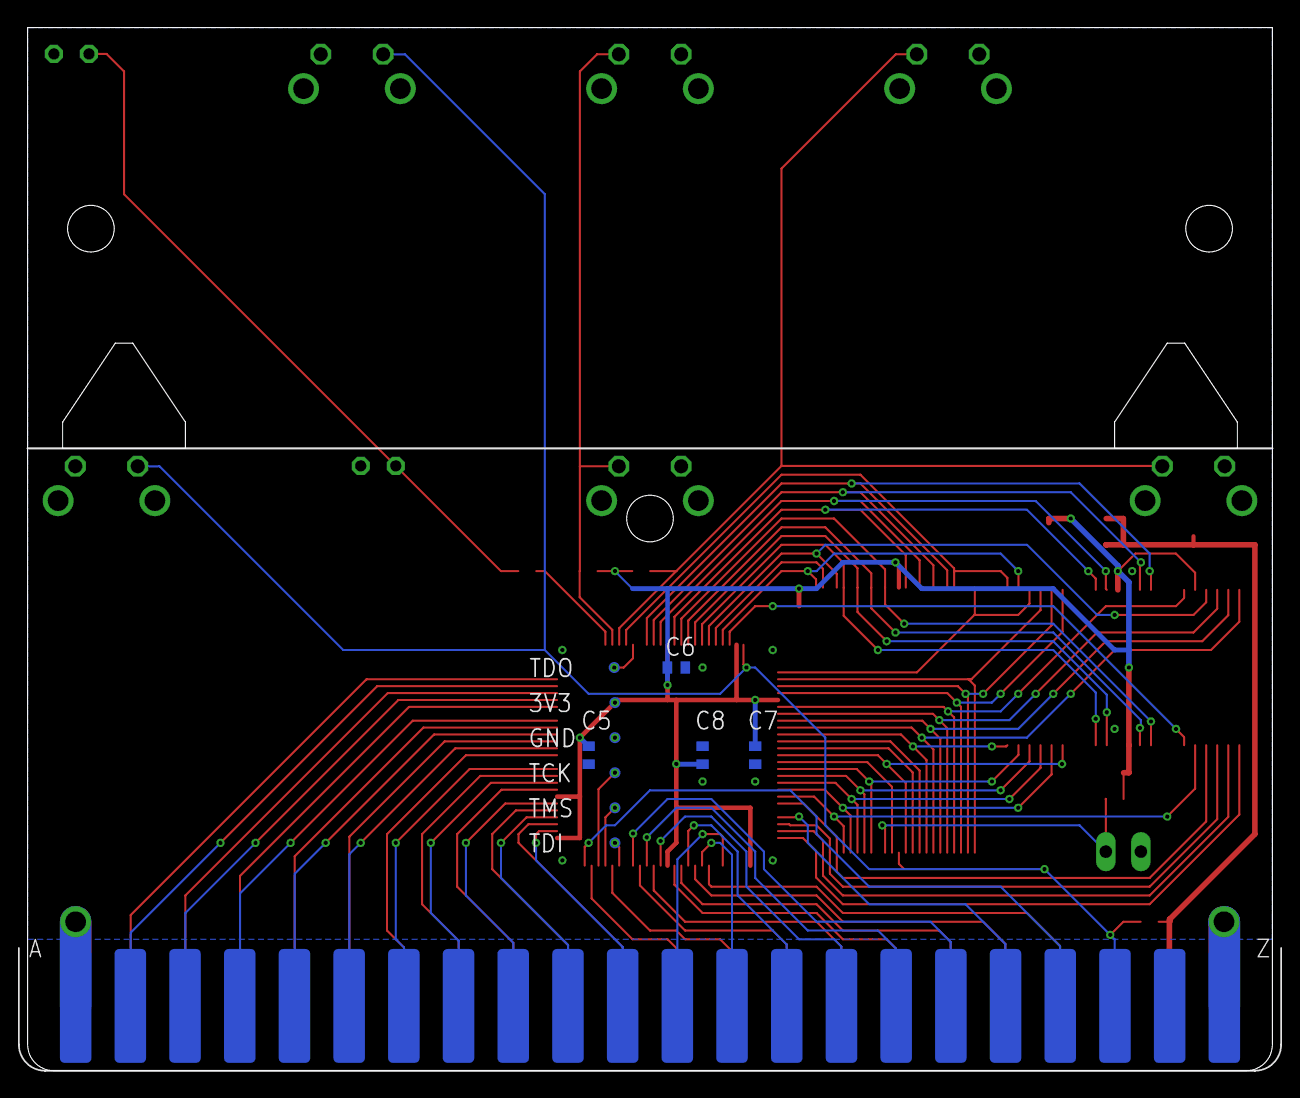
[picture p29: board UltiMem_v1.02.brd from below]

Board: 2 copper layers, 90.2 x 75.6 mm, 33 parts (10 on the bottom side), 84 nets.
