go4retro/UltiMEM/media/P60222-145645(02-22-15-19-55).jpg

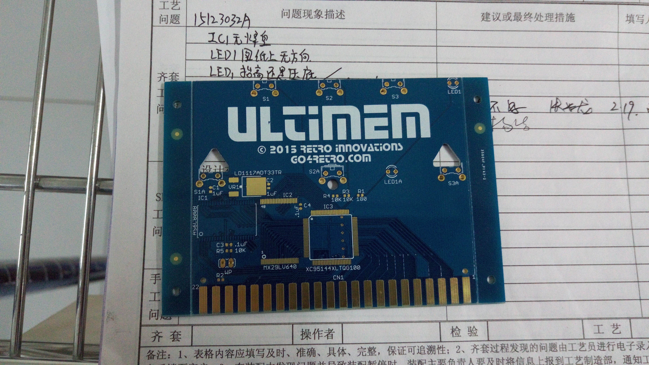
media/P60222-145645(02-22-15-19-55).jpg
